beschasny/runup/(commit log)

2025-08-23 feat: add initial Arduino Pomodoro sketch
2025-08-30 docs: add wiring diagram
2025-09-16 docs: update wiring diagram
2025-09-21 docs(readme): add illustrations for assembly steps
2025-09-21 docs(readme): add assembly instructions section
2025-10-13 fix(rtc): open datetime setup on first start instead of error
    [runup-arduino-pomodoro-mfs.ino]
2025-12-26 docs(readme): enclosure with buttons illustration
2026-01-17 refactor(rtc): replace RTC library and update API usage
    [runup-arduino-pomodoro-mfs.ino]
2026-01-18 fix(rtc): clamp digits and adjust formatting
    [runup-arduino-pomodoro-mfs.ino]
2026-03-14 fix(sleep-mode): improve sleep mode compatibility
    Added ADC disable for sleep mode and updated sleep function.
    [runup-arduino-pomodoro-mfs.ino]
2026-03-14 fix(rtc): add isDateSet flag and improve first-run date setting logic
    Added isDateSet flag to Config struct and updated logic to handle date initialization.
    [runup-arduino-pomodoro-mfs.ino]
2026-03-16 docs(readme): update wiring diagram
2026-03-16 docs(readme): update rtc cable routing diagram
2026-06-25 docs(readme): add visuals and revise readme
    Updated project title and description in README. Added images and modified tool requirements for enclosure.
